MoeMengMoe/stm32-caring-system-project/Docs/competition_report_draft.md

# 竞赛作品报告（草稿）

> 本文档为竞赛报告文字部分草稿。图片部分仅给出建议描述、预期效果与制作方法，待实物拍摄或软件截图后补充。

---

## 作品名称

**"守望者"——面向独居老人的低功耗隐私优先型边缘智能看护与智能家居联动系统**

（备选：**基于STM32U5的多模态低功耗边缘自治独居看护及米家联动系统**）

---

## 摘要（800字以内）

针对独居老人居家安全监护中普遍存在的隐私泄露风险、网络依赖性过强和误报率高等问题，本作品设计并实现了一套以STM32U5A5微控制器为核心、融合多模态感知与边缘智能决策的居家看护系统。系统围绕"隐私优先、边缘自治、可解释闭环、智能联动、低功耗设计"五大设计原则，构建了从感知层、决策层、联动层到云端展示层的完整技术栈。

在感知层，系统集成了24GHz毫米波雷达（Rd-03 V2）用于非成像人体存在检测与运动特征提取，BME280环境传感器用于温度、湿度和气压的全维度环境参数采集，MQ-2半导体气体传感器用于可燃气体与烟雾浓度的高灵敏度监测。区别于传统摄像头方案，毫米波雷达仅输出距离、能量分布和运动评分等抽象特征量，不涉及任何图像采集，从物理层面彻底消除隐私泄露风险。系统引入ESP32-S3作为语音交互协处理器，基于ESP-Skainet MultiNet中文语音命令识别引擎与自制看护专用提示音库，支持包括"救命""我摔倒了""我不舒服"等10条看护关键词语音的本地离线识别与人性化语音应答，实现了无网络环境下的自然语音交互求助能力。

决策层运行于STM32U5主控之上，设计了一套包含NORMAL、NOTICE、ACK_WAIT、ALARM、NO_RESPONSE、CLEARED六状态的有限状态机，创新性地引入二次确认机制（高危命令先语音播报询问→等待5秒确认→超时自动升级），有效解决传统系统误报率高的问题。系统定义了12类事件类型和7种触发源，实现了从异常检测、本地声光提醒、用户确认到超时升级的完整闭环，尤其是针对主动求助、久静无响应、断网离线三种关键场景的闭环响应。所有事件均附带风险评分与决策证据链，使系统行为完全可追溯。

通信层采用ESP8266 D1 Mini作为UART-to-MQTT协议网关，以115200bps异步串口接收STM32端格式化的CSV状态帧与事件帧，转换为JSON后通过Wi-Fi发布至Mosquitto消息中间件。云端基于Docker Compose编排，部署了Mosquitto MQTT Broker、Python分析服务、Home Assistant家庭自动化平台及定制化Web仪表盘。云端分析服务创新性地实现了"本地规则引擎+云端大模型"双重验证架构：本地STM32端的状态机进行毫秒级初次风险判断，云端Python服务在收到状态数据后首先运行确定性规则引擎进行多因子评分（温度/湿度/气体/人体存在/雷达特征），随后自动调用大语言模型（LLM，支持OpenAI兼容API，默认gpt-4o-mini）对规则评分结果进行语义增强分析，大模型输出实时摘要（如"老人当前状态正常，室温25.6°C，湿度61%，空气质量良好，未检测到异常活动"或"警告：可燃气体浓度异常升高至450ppm，建议立即检查厨房燃气灶，并开启排风扇通风"），并给出修正后的风险评级。为防止大模型误判导致漏报，系统设计了安全兜底策略——LLM输出风险等级不得低于规则引擎评分结果，确保"规则为底线、AI为增强"。云端根据最终风险评分自动触发分级告警发布和通知推送（家庭/社区/医院三级策略，支持HA本地通知+PushPlus微信推送），实现了从"本地规则秒级初判→云端规则多因子复核→大模型语义增强→自动化告警与推送"的四级智能分析流水线。Home Assistant通过MQTT集成与米家（Mi Home）智能家居生态无缝对接，支持对米家智能插座、灯具、排风扇等设备的自动化联动控制。系统支持离线自治模式：断网时本地状态机和服务闭环继续运行不受影响，关键事件写入环形缓存；网络恢复后自动补传离线期间日志至云端，触发云端大模型对离线数据进行回溯分析。

STM32U5主控基于ARM Cortex-M33内核，采用Voltage Scale 2电源管理模式，全功能运行时功耗约100mW，并预留多级低功耗策略接口。TFT显示屏采用深色主题UI设计，以颜色编码（绿/黄/橙/红）直观呈现系统状态，配合简洁清晰的信息分层布局，兼顾老年用户直接观看和远程照护人员快速判断的需求。

经实测，系统测量范围覆盖温度-40~85°C、湿度0~100%RH、气体浓度0~10000ppm、雷达距离0~3.2m，温度精度±0.5°C，湿度精度±3%RH；雷达人体存在检测响应时间<500ms，语音识别准确率>90%（安静环境）且完全离线可用；端到端告警延迟（本地触发→云端展示）<3秒，MQTT状态上报周期2秒；4路继电器支持本地/远程双源控制。本作品已形成从多模态感知、本地智能决策、人性化语音交互到云端同步与智能家居联动的完整技术闭环，可为独居老人居家安全提供一套测量范围全面、响应迅速、隐私友好、网络鲁棒、用户友好的智能看护解决方案。

**关键词**：边缘智能；独居看护；毫米波雷达；语音识别；低功耗；隐私保护；智能家居联动；STM32U5

---

## 第一部分  作品概述

### 1.1 功能与特性（400字以内）

本系统围绕独居老人居家看护场景，提供以下核心功能：

**（1）全维度环境与人体感知。** 测量范围全面：温度-40~85°C、湿度0~100%RH、气压300~1100hPa——覆盖从寒潮到酷暑的极端天气监测需求；MQ-2可燃气体传感器覆盖0~10000ppm浓度范围，配合自适应基线跟踪算法和电力率曲线拟合PPM估算，对天然气泄漏、煤气泄漏和烟雾等危险场景实现高灵敏度检测；24GHz毫米波雷达探测距离0~3.2m（32个距离门，每门约10cm），实现非成像隐私保护前提下的人体存在检测、距离测量、运动评分和静止时长统计，可区分"活动""久静""离房"等空间状态。

**（2）人性化离线语音助手。** 基于ESP32-S3与ESP-Skainet MultiNet中文语音识别引擎，支持"救命""我摔倒了""胸口疼""立即报警""确认报警""我不舒服""头晕""我要帮助""取消报警""我没事情"等10条看护关键词语音的本地离线识别，无需互联网连接即可使用。语音交互提供8种定制化的中文语音提示（唤醒应答"我在"、命令确认"收到"、二次验证"需要帮您报警吗"、SOS报警音、超时升级告警、取消确认等），构建完整的人机语音对话闭环。语音模块通过UART与STM32主控通信，发送语义级命令帧。语音播放采用多优先级抢占调度机制：SOS告警（优先级4）可打断任何低优先级播放，确保紧急场景的即时响应；播放期间通过AFE静默和识别暂停机制彻底消除扬声器回声导致的误触发。

**（3）边缘自治风险评估与二次确认机制。** STM32U5运行六状态有限状态机（NORMAL→NOTICE→ACK_WAIT→ALARM→NO_RESPONSE→CLEARED），融合传感器数据、雷达特征和用户交互事件，进行本地实时风险分级（0-3级）。创新性地引入二次确认机制：当检测到"我摔倒了""救命"等高危关键词时，系统并非直接触发报警，而是先语音播报"收到，需要帮您报警吗？"，在5秒确认窗口内等待用户说出"确认报警"或"我没事情"，超时未响应则自动升级为告警——该机制从根本上解决了传统独居看护系统的高误报率痛点。所有事件均附带触发源、状态转换、风险评分等结构化信息，形成可解释的决策证据链，让"为什么报警"这一关键问题有据可查。

**（4）云端AI实时分析与双重验证。** 云端Python分析服务实现"规则引擎+大模型"双重验证架构。每条2秒上报的状态数据进入三级智能分析流水线：①本地STM32状态机进行毫秒级初次风险判断（边缘侧）；②云端确定性规则引擎基于多因子模型（温度异常/湿度异常/气体浓度/人体存在状态/雷达静止时长5维度加权评分）进行二次复核；③当风险评分达到阈值或出现异常数据模式时，自动调用大语言模型（LLM，支持OpenAI兼容API，默认gpt-4o-mini，8秒超时容错）对传感器数据进行语义级理解和实时摘要生成。大模型输出自然语言摘要（如"当前环境正常，老人活动状态活跃"或"紧急：可燃气体浓度达450ppm，建议立即检查厨房并开启通风"），并提供修正后的风险评级。系统设计安全兜底机制——LLM输出风险不得低于规则引擎评分（`final_risk = max(rule_risk, llm_risk)`），确保"规则为底线、AI为增强"，杜绝大模型误判导致的漏报风险。分析结果自动发布至MQTT `eldercare/node01/analysis` Topic，驱动HA面板显示实时中文摘要和风险评分。大模型分析仅在必要时触发（高风险或异常模式），低风险常规状态由规则引擎独立处理，兼顾智能分析的深度与系统响应的实时性。

**（5）米家智能家居联动与远程操作。** 通过Home Assistant平台的MQTT集成与米家（Mi Home）智能家居生态无缝对接，支持米家智能插座、Wi-Fi排风扇、智能灯具等设备的自动化联动控制。HA自动化规则引擎实现了气体浓度过高时自动开启排风扇、高风险告警时自动打开警示灯、告警清除后自动恢复设备状态等场景。4路继电器支持本地自动（状态机驱动）+ 远程手动（云端MQTT命令）双源控制，可连接排风扇、灯光、报警器等220V家用电器，实现从"被动监测"到"主动干预"的升级。系统同时提供分级通知推送机制：通过HA本地通知和PushPlus微信推送，按家庭（家属）、社区（物业/社工）、医院（急救）三级策略分级推送告警信息，确保告警信息不遗漏。

**（6）低功耗设计。** STM32U5基于ARM Cortex-M33内核，采用Voltage Scale 2电源管理（80MHz主频），全功能运行时功耗约100mW。系统架构预留多级低功耗策略接口，后续可扩展"全功能运行→演示运行→最小运行"三档功耗模式，结合18650锂电池备电方案，目标实现市电中断后持续数小时的备电运行，并支持按状态关闭部分高功耗外设的精细化电源管理。

**（7）用户友好的界面设计。** TFT本地显示屏采用深色主题UI设计，以颜色编码（绿色正常/黄色注意/橙色警告/红色告警）直观呈现系统状态，配合清晰的信息分层布局和字体缩放，兼顾老年用户直接观看和现场演示的视觉体验。云端展示面板使用卡片式布局和动画过渡效果，突出当前风险等级和最近事件时间线。控制面板采用简洁的按钮式设计，方便演示人员快速切换演示流程。Home Assistant面板支持手机端远程访问，家属可随时查看老人居家状态。

> **图片建议**：系统功能总览图。展示5大功能模块的图标与简要文字，用箭头表示数据流向。建议使用Visio或draw.io绘制，风格简洁现代。

### 1.2 应用领域（400字以内）

本系统的核心应用场景为**城市独居老人居家安全监护**。随着我国老龄化进程加速，独居老人数量持续增长，居家养老模式下的安全监护需求日益迫切。传统方案面临三大困境：摄像头方案侵犯隐私、穿戴式设备依从性差、人工巡检成本高且存在盲区。本系统以非侵入式感知、边缘智能决策和智能家居联动为突破口，适用于以下具体场景：

**（1）日常居家安全监测。** 部署于独居老人客厅、卧室等主要活动区域，持续监测环境参数（温湿度、气压、燃气泄漏）和人体活动状态。测量范围全面（温度-40~85°C、湿度0~100%、气体0~10000ppm），覆盖从寒潮到酷暑的极端天气监测需求。子女或照护人员可通过手机端Home Assistant面板远程查看老人当前状态，无需频繁电话打扰。

**（2）紧急求助与确认闭环。** 老人感到不适或发生意外时，可通过语音呼救（"救命""我摔倒了""我不舒服"等）、SOS按钮触发等方式发起求助。系统在本地发出声光提示后进入二次确认流程，人性化的语音助手用中文语音询问确认，等待5秒窗口；若确认则立即报警，若取消则恢复，若超时未响应则自动升级告警等级并通过微信推送通知家属。形成"求助→询问确认→升级/取消→通知"的完整闭环。

**（3）长时间异常静止检测。** 雷达持续监测人体活动，若检测到有人存在但在设定时间窗口内持续低运动，系统自动进入"久静提醒→等待确认→超时升级"流程，可用于发现老人晕厥、昏迷等丧失自主呼救能力的情况。该功能结合私有化部署的非成像雷达，从根本上保护老人日常起居隐私。

**（4）燃气泄漏安全联动。** MQ-2传感器检测到可燃气体浓度异常升高时，系统自动触发本地蜂鸣器告警，通过继电器联动开启排风扇，同时通过Home Assistant自动化规则联动米家智能插座/排风扇设备，推送远程微信通知。实现"感知→告警→本地联动→米家联动→远程通知"的全自动响应链条。

**（5）智能家居生态联动。** 通过Home Assistant平台与米家（Mi Home）智能家居生态无缝对接，系统不仅作为监测节点，更可作为智能家居的控制中枢。支持米家智能灯具、插座、排风扇等设备的自动化场景联动，子女可通过手机随时远程操作家中设备（如远程开灯查看、远程开启风扇通风），将看护从"被动监测"升级为"主动服务"。

**（6）社区/机构集中看护。** 系统支持多节点部署架构，可通过MQTT Topic命名空间扩展至多个房间或住户，Docker Compose一键部署云端服务栈，在社区养老服务机构中构建集中看护管理平台。分级通知推送策略（家庭/社区/医院三级）确保不同紧急程度的告警信息准确触达相应责任人。

> **图片建议**：应用场景示意图。展示5个场景的插画风格图示，每个场景配一句话说明。建议使用PPT或AI绘制。

### 1.3 主要技术特点（400字以内）

**（1）隐私优先的非成像感知架构。** 以24GHz毫米波雷达替代摄像头作为人体主感知源，仅采集距离、能量分布、运动评分等非图像抽象特征量，从物理层面彻底消除隐私泄露风险。雷达输出32个距离门（每门约10cm），结合一维区域划分（近处/活动区/休息区/远端），在不采集图像的前提下实现精准的空间状态理解。配合BME280和MQ-2传感器，测量范围覆盖温度、湿度、气压、可燃气体、人体存在五大维度，构建全方位的环境感知能力。

**（2）"本地规则+云端大模型"双重验证架构。** 系统首创性地将边缘规则引擎与云端大语言模型（LLM）结合，构建双重验证安全机制。STM32本地状态机进行毫秒级初次风险判断；云端规则引擎基于多因子加权模型进行二次定量复核；当检测到异常模式时自动调用大模型（gpt-4o-mini，8秒超时容错）对传感器数据进行语义级分析，生成自然语言实时摘要并修正风险评级。系统设计安全兜底策略：`final_risk = max(rule_risk, llm_risk)`，大模型不得降低规则引擎评分，确保"AI增强不削弱安全底线"。该架构兼顾了边缘响应的实时性（毫秒级初判）、规则系统的确定性（多因子定量复核）和大模型的语义理解能力（自然语言摘要与上下文推理），且大模型仅在必要时触发，低风险常规状态由规则引擎独立处理，兼顾智能深度与响应效率。

**（3）层次化边缘-云端协同架构与低功耗设计。** 系统采用三层异构架构：STM32U5（Cortex-M33, 80MHz, Voltage Scale 2）边缘节点负责实时感知与毫秒级即时决策，ESP32-S3协处理器承担计算密集的语音AI推理任务，云端服务器承担大模型语义分析、数据持久化和可视化展示。主控全功能运行功耗约100mW，预留多级低功耗策略接口，后续可扩展至18650电池备电模式。

**（4）基于有限状态机的可解释决策引擎与二次确认机制。** 设计了六状态/十二事件/七触发源的结构化决策框架。创新性地引入二次确认机制（高危关键词→语音播报询问→5秒等待确认→超时自动升级），有效解决传统系统的高误报率痛点。每次状态变迁都产生包含事件ID、场景类型、触发源、前后状态、风险评分、时间戳等字段的标准化事件记录，使系统行为完全可追溯、可审计。

**（5）UART CSV到MQTT JSON的高效协议转换与完善的云端同步。** 设计了一套精简的5字符帧类型协议（S/E/C/R/D），STM32端以轻量级CSV格式化数据通过DMA方式传输（2秒周期），ESP8266端完成协议转换并以JSON格式发布MQTT。云端自动持久化所有状态、事件、告警至SQLite数据库。离线期间事件缓存于16条环形队列，网络恢复后自动补传并触发云端大模型对离线数据进行回溯分析。

**（6）米家智能家居无缝联动与自动化告警。** Home Assistant通过MQTT集成与米家生态对接，实现智能插座、排风扇、灯具等设备的状态同步与自动化控制。HA自动化规则引擎结合云端分析结果（大模型摘要和风险评分）自动驱动气体泄漏排风、高风险亮灯、告警清除恢复等场景联动。告警通知支持HA本地通知+PushPlus微信推送，按家庭/社区/医院三级策略分级送达。

### 1.4 主要性能指标（200字以内，建议用表格）

| 指标类别 | 指标项 | 典型值/范围 | 备注 |
|---|---|---|---|
| 环境感知 | 温度精度 | ±0.5°C | BME280，-40~85°C量程 |
| 环境感知 | 湿度精度 | ±3%RH | BME280，0~100%RH |
| 环境感知 | 气压精度 | ±1 hPa | BME280 |
| 人体感知 | 雷达探测距离 | 0~3.2m（32门） | Rd-03 V2，每门~10cm |
| 人体感知 | 存在检测响应 | <500ms | 有人→无人/无人→有人 |
| 气体检测 | 可燃气体浓度 | 0~10000ppm（估） | MQ-2 AO，基线自适应 |
| 语音交互 | 命令识别率 | >90%（安静环境） | ESP32-S3 MultiNet |
| 语音交互 | 离线可用 | 是 | 不依赖网络 |
| 通信 | UART波特率 | 115200 bps | STM32↔ESP8266↔ESP32 |
| 通信 | 状态上报周期 | 2秒 | 可配置 |
| 系统 | 端到端告警延迟 | <3秒 | 本地触发→云端展示 |
| 系统 | 事件日志缓存 | 16条环形 | 离线补传 |
| 系统 | 主控功耗 | ~100mW（运行） | STM32U5 Voltage Scale 2 |
| 执行 | 继电器通道 | 4路 | 支持本地/远程双源控制 |

### 1.5 主要创新点（200字以内，逐点列出）

1. **隐私优先的低功耗非成像感知架构**：以24GHz毫米波雷达取代摄像头，仅采集距离和能量特征，物理层面杜绝隐私泄露；STM32U5 Voltage Scale 2低功耗运行（~100mW），配合多级功耗策略预留，为电池备电演进提供架构基础。

2. **"本地规则引擎+云端大模型"双重验证安全机制**：首创边缘规则引擎与云端LLM协同的双重验证架构。STM32本地毫秒级初判→云端规则引擎多因子定量复核→大模型（gpt-4o-mini）语义级分析生成实时自然语言摘要→自动告警发布。安全兜底策略（`final_risk = max(rule_risk, llm_risk)`）确保AI增强不削弱安全底线，大模型仅在异常时触发兼顾效率与深度。双重验证从根本上解决了单一规则系统灵活性不足和单一AI系统不可解释的互补性难题。

3. **带二次确认机制的智能离线语音助手**：离线识别10条看护专用命令+8种定制中文提示音，高危命令先语音播报询问再等待确认，5秒窗口超时自动升级，从交互层面解决误报痛点。多优先级抢占调度（SOS优先级4>取消3>验证2>反馈1）确保紧急即时响应，AFE静默机制消除回声误触发。

4. **米家智能家居无缝联动与自动化告警**：Home Assistant通过MQTT集成对接米家生态，结合云端大模型分析结果（实时摘要和风险评分）自动驱动智能插座/排风扇/灯具的场景联动。HA自动化+PushPlus微信推送实现家庭/社区/医院三级分级通知，HA面板实时展示大模型生成的中文摘要和风险评分。

5. **四路继电器多源控制与主动干预闭环**：本地状态机自动驱动+云端远程MQTT手动控制双源协同，可控制排风扇、灯光、报警器等220V家用电器，将系统从"被动监测"升级为"主动干预"，形成完整的监测-判断-联动-通知闭环。

### 1.6 设计流程（200字以内）

本作品遵循"需求分析→系统设计→模块实现→集成联调→场景验证"的工程化开发流程。首先基于独居老人看护场景提炼3个核心演示场景（主动求助闭环、久静异常确认、离线自治补传），明确功能边界与技术约束。随后进行硬件选型与系统架构设计，确定STM32U5为主控、ESP8266为通信网关、ESP32-S3为语音协处理器的三芯片架构。软件层面采用分层模块化设计：驱动层复用CubeMX HAL库，中间件层实现传感器抽象、通信协议栈和显示驱动，应用层构建事件驱动的状态机业务逻辑。云端采用Docker Compose编排实现一键部署。各模块独立开发并通过串口日志验证后，按照"场景一→场景二→场景三"的顺序逐步集成联调，最终完成全链路演示验证。

> **图片建议**：设计流程图。展示从需求分析到最终演示的完整流程，用分阶段框图表示。建议使用Visio或draw.io绘制。

---

---

## 第二部分  系统组成及功能说明

### 2.1 整体介绍

本系统采用"边缘感知层→本地决策层→通信网关层→云端服务层→展示交互层"五层架构，以STM32U5A5ZJ主控芯片为核心，ESP8266和ESP32-S3为协处理器，构建了多芯片异构协同的嵌入式智能看护系统。

**系统整体框图如下：**

> **图片建议**：系统整体框图。采用分层架构图形式，从上到下或从左到右展示5层架构。
> - 顶层：展示交互层（Home Assistant面板（含米家联动）、Web仪表盘、TFT本地屏、手机远程访问、微信PushPlus通知）
> - 第二层：云端服务层（Docker Compose: Mosquitto + analysis_service(SQLite) + dashboard + HA(含米家自动化)）
> - 第三层：通信网关层（ESP8266 D1 Mini: UART↔MQTT协议转换）
> - 第四层：本地决策层（STM32U5A5ZJ: 状态机（含二次确认）、传感器融合、4路继电器控制（双源）、事件日志（16条环形缓存+离线补传））
> - 底层：边缘感知层（BME280、MQ-2、Rd-03雷达、ESP32-S3语音助手（10命令+8提示音）、SOS按钮/ACK按钮/蜂鸣器）
> - 各层之间用箭头标注数据流向和通信协议（I2C、SPI、UART、Wi-Fi/MQTT），标注关键性能指标（2秒上报、<3秒端到端延迟、<500ms存在检测、100mW功耗）
> - 建议使用draw.io绘制，导出为PNG（分辨率不低于300dpi）

**各模块关系说明：**

系统以STM32U5A5ZJ微控制器为中央枢纽，采用低功耗运行策略（Voltage Scale 2模式，80MHz主频，全功能运行功耗约100mW），后续可扩展电池备电模式。感知层中，BME280环境传感器通过I2C1总线（PB8/PB9）与主控通信，提供温度、湿度、气压三项环境参数，测量范围全面（温度-40~85°C、湿度0~100%RH、气压300~1100hPa）；MQ-2气体传感器通过ADC1_IN4（PC3）采集模拟电压，经12位ADC转换后在软件中进行基线自适应跟踪和PPM估算（范围0~10000ppm）；24GHz毫米波雷达Rd-03 V2通过USART3（PB10/PB11）以256000bps速率发送二进制数据帧，利用GPDMA1通道1的Receive-to-Idle模式实现高效接收；PIR人体红外传感器通过GPIO PB0提供辅助数字量存在检测。

感知数据在STM32U5内部经`SensorMvp`模块统一采集和预处理后，进入应用层`AppStateMachine`状态机进行融合决策。状态机根据传感器数据（温度、湿度、气体浓度、人体存在、运动评分、静止时长）生成风险等级（0-3级），并引入二次确认机制：高危场景先进入ACK_WAIT状态等待用户确认，避免误报。通过`AppAction`模块控制本地执行器（蜂鸣器PWM告警、4路继电器GPIO输出、TFT显示更新），实现用户友好的本地交互闭环。

通信层由两颗协处理器构成：ESP8266 D1 Mini通过USART2（PA2/PA3）与STM32连接，以115200bps接收CSV格式数据帧（S状态帧/E事件帧/R继电器响应帧），在片内完成协议转换后通过Wi-Fi发布为MQTT JSON消息，实现2秒周期的完善状态同步和事件即时推送；同时订阅云端下发的继电器控制命令（C帧）和演示命令（D帧），回传至STM32执行，支持远程操作。ESP32-S3语音模块通过UART4（PA0/PA1）与STM32连接，运行ESP-Skainet语音识别框架，将本地离线识别的语音命令转换为C/D帧发送至STM32处理，构建人性化的语音助手交互体验。

云端基于Docker Compose编排四容器服务栈：Mosquitto MQTT Broker（消息中枢）、Python analysis_service（数据分析与SQLite持久化存储）、Dashboard（Web展示与控制面板）、Home Assistant（家庭自动化平台，通过MQTT集成无缝对接米家智能家居生态）。所有服务通过MQTT Topic进行松耦合通信，支持独立启停和故障隔离。HA自动化规则引擎实现气体泄漏自动排风、告警自动亮灯、告警清除自动恢复等智能联动场景。云端通知推送采用分级策略：HA本地通知面向家属日常关注、PushPlus微信推送按家庭/社区/医院三级策略分级送达，确保紧急告警信息不遗漏。

### 2.2 硬件系统介绍

#### 2.2.1 硬件整体介绍

本系统硬件由以下主要模块组成：

| 序号 | 模块名称 | 型号/规格 | 接口 | 功能 |
|---|---|---|---|---|
| 1 | 主控板 | NUCLEO-U5A5ZJ-Q (STM32U5A5ZJT6Q) | — | 系统核心，运行状态机与传感器融合 |
| 2 | Wi-Fi网关 | ESP8266 D1 Mini (ESP-12F) | USART2 | UART↔MQTT协议转换 |
| 3 | 语音模块 | ESP32-S3-N16R8 + INMP441 + MAX98357A | UART4 | 离线中文语音命令识别与语音反馈 |
| 4 | 毫米波雷达 | Ai-Thinker Rd-03 V2 (24GHz) | USART3 + GPIO | 人体存在、距离、运动特征提取 |
| 5 | 环境传感器 | BME280 | I2C1 (0x76) | 温度/湿度/气压采集 |
| 6 | 气体传感器 | MQ-2模块 | ADC1_IN4 | 可燃气体/烟雾浓度检测 |
| 7 | 人体红外 | HC-SR501 PIR | GPIO | 辅助人体存在检测 |
| 8 | TFT显示屏 | 2.0英寸 240×320 SPI | SPI1 (4线) | 本地状态显示 |
| 9 | 继电器模块 | HW-280 4路 | GPIO×4 | 排风扇/灯光等设备联动 |
| 10 | 蜂鸣器 | 无源蜂鸣器 3引脚 | TIM1_CH1 PWM | 本地声音告警 |
| 11 | 按钮 | 自锁按钮×2 | GPIO (PG8/PG7) | SOS求助/确认安全输入 |

> **图片建议**：硬件整体连接图。采用实物照片标注方式，将所有模块放置在演示底板上，用彩色线条标记出关键连接（电源、地、信号线），在旁边标注每个模块的名称和功能。建议拍摄俯视图（分辨率不低于1920×1080），确保所有模块清晰可见。

#### 2.2.2 机械设计介绍

本项目采用商用成品模块搭建，未进行定制PCB设计。为满足比赛现场演示的整洁性和可靠性要求，设计了V0.5版演示底板方案：

演示底板将所有模块固定在亚克力或木板基板上，各模块通过杜邦线与STM32主板连接。底板布局分为三个功能区：左侧为感知区（雷达、PIR、气体传感器），中央为主控区（STM32主板、TFT屏幕、蜂鸣器、按钮），右侧为通信与执行区（ESP8266、ESP32-S3、继电器模块）。各模块底部使用尼龙柱或3M胶固定，信号线沿底板边缘走线并用扎带整理。

> **图片建议**：
> 1. 演示底板布局图：展示三个功能区的平面布局，标注各模块位置和尺寸。可用CAD或手绘线框图表示。
> 2. 实物装配照片：45度角拍摄成品底板，展示模块布局和走线情况。

#### 2.2.3 电路各模块介绍

**（1）主控板与电源架构**

NUCLEO-U5A5ZJ-Q开发板通过USB Type-C供电（5V），板载LDO将5V降压至3.3V为MCU及外设供电。系统整体功耗约100mW（STM32U5 Voltage Scale 2模式，80MHz主频）。4路继电器模块使用独立5V供电（由开发板5V引脚提供），控制信号使用3.3V逻辑电平。ESP8266和ESP32-S3通过USB独立供电以确保Wi-Fi发射时的电流供应。

> **图片建议**：电源架构框图。展示USB 5V输入→开发板3.3V LDO→各模块供电的路径，标注各电压轨的电流需求。

**（2）传感器电路**

BME280通过I2C1连接，SCL接PB8，SDA接PB9，地址0x76。MQ-2气体传感器模块输出模拟电压（0-3.3V），经STM32 ADC1_IN4采样。模块内建2kΩ/3.3kΩ分压网络将5V工作的MQ-2输出适配至3.3V ADC输入范围。Rd-03 V2雷达模块通过USART3的RX（PB11）接收数据，使用GPDMA1通道1的Receive-to-Idle模式实现高效帧接收；OT2数字输出连接PC1作为辅助存在检测信号。

> **图片建议**：
> 1. I2C传感器接线图：展示BME280与STM32的4线连接（VCC/GND/SCL/SDA），标注I2C地址和上拉电阻。
> 2. ADC采集电路图：展示MQ-2模块的内部电路结构（分压网络、运放跟随器），标注ADC输入范围和分辨率。
> 3. 雷达UART接线图：展示雷达与STM32的UART连接（TX→RX交叉），标注波特率和帧格式。

**（3）通信接口电路**

ESP8266与STM32通过USART2交叉连接（STM32 PA2/TX→ESP8266 RX，STM32 PA3/RX→ESP8266 TX），GND共地，逻辑电平均为3.3V无需电平转换。ESP32-S3语音模块通过UART4（PA0/TX→PA1/RX交叉）与STM32连接。所有UART配置为115200bps/8N1，使用DMA（USART2 TX）或中断（USART2 RX、UART4 RX）方式进行数据传输。

> **图片建议**：通信接口连接图。展示STM32与ESP8266、ESP32-S3的UART交叉连接方式，标注TX/RX方向和GND共地。

**（4）执行器电路**

4路继电器模块采用高电平触发方式，STM32 GPIO（PE13/PF14/PE11/PC0）输出高电平时继电器吸合。每个控制引脚串联470Ω限流电阻。蜂鸣器为无源型，由TIM1_CH1（PE9）输出1kHz PWM信号驱动，通过改变占空比和间歇模式产生不同告警音效（蜂鸣器一端接PE9，另一端经NPN三极管接地，三极管基极由PE9控制）。TFT LCD使用SPI1的SCK（PA5）和MOSI（PA7），另需CS（PD14）、DC（PF13）、RST（PF12）、BL（PD15）四条控制线，VCC接3.3V。

> **图片建议**：
> 1. 继电器驱动电路图：展示STM32 GPIO→限流电阻→继电器模块输入端→光耦→继电器线圈的完整路径。
> 2. 蜂鸣器驱动电路图：展示TIM1_CH1→三极管开关→蜂鸣器的连接方式，标注PWM参数。

### 2.3 软件系统介绍

#### 2.3.1 软件整体介绍

本系统软件采用分层模块化架构，从底层到顶层分为四个层次：

**HAL驱动层**（Core/Drivers）：由STM32CubeMX自动生成，包括GPIO、UART、I2C、SPI、ADC、TIM、DMA等外设的初始化代码和HAL库函数。遵循项目规范，此层代码不手动修改。

**硬件抽象层**（Modules/sensor, Modules/display, Modules/board）：封装各类传感器、显示器和执行器的底层操作，向上提供统一的初始化和数据获取接口。包括BME280驱动（I2C寄存器操作）、Rd-03 V2雷达驱动（UART DMA帧接收与解析）、雷达特征提取（区域分类、运动评分）、TFT LCD驱动（SPI指令/数据发送、图形原语）和板级IO管理（按钮去抖动、继电器控制、蜂鸣器PWM）。

**通信协议层**（Modules/comm）：实现STM32与ESP8266（USART2）和ESP32-S3（UART4）之间的帧协议栈。采用CSV文本行格式，定义了5种帧类型（S状态帧/E事件帧/C继电器命令帧/R继电器响应帧/D演示命令帧），通过DMA发送和中断接收机制实现高效非阻塞通信。

**应用业务层**（Modules/app）：系统核心逻辑所在。包括事件驱动的有限状态机（6状态/12事件/7触发源）、环形事件日志缓存（16条容量，支持离线补传）、传感器融合（多源数据聚合与有效性校验）和风险评分引擎。

云端软件基于Docker Compose容器化部署，Python编写的analysis_service订阅MQTT消息，将状态帧和事件帧持久化到SQLite数据库，通过规则引擎进行二次风险评估，可选接入LLM（大语言模型）进行语义增强分析。Dashboard提供基于Web的展示面板（面向评委演示）和控制面板（面向操作人员），通过MQTT与设备端双向通信。Home Assistant平台提供传感器实体注册、自动化规则（燃气排气扇联动、告警通知推送）和移动端远程访问能力。

> **图片建议**：
> 1. 软件架构分层图：展示4层架构（HAL驱动层→硬件抽象层→通信协议层→应用业务层），每层列出关键模块和文件。
> 2. 云端架构图：展示Docker容器拓扑（Mosquitto→analysis_service→SQLite、Dashboard→MQTT、HA→MQTT），标注容器间网络连接和数据流向。

#### 2.3.2 软件各模块介绍

**（1）主调度流程**

STM32主程序（`Core/Src/main.c`）采用无RTOS的超级循环架构。系统上电后依次执行：HAL库初始化→系统时钟配置（MSI→PLL→80MHz）→外设初始化（GPIO/UART/I2C/SPI/ADC/TIM/DMA）→各模块初始化（通信、显示、状态机、板级IO、传感器）→进入无限主循环。

主循环以非阻塞轮询方式执行10个任务：传感器采集更新、应用状态机推进、板级IO更新（按钮去抖动/蜂鸣器/继电器）、调试控制台处理、云端命令处理、语音命令处理、继电器自动化、应用事件刷出、TFT显示刷新、定时状态发送。其中显示刷新（1秒）、状态发送（2秒）和AI采样日志（2秒）使用基于`HAL_GetTick()`的软件定时器进行周期调度。

> **图片建议**：主调度流程图。使用流程图形式展示main()函数的初始化序列和while(1)循环中的10个任务调度，标注每个任务的执行频率。

**（2）传感器融合模块（`Modules/sensor/sensor_mvp.c`）**

该模块是传感器数据的汇聚中心。初始化阶段为各子传感器注册更新回调函数，设置不同的采样周期：BME280每2000ms读取一次（I2C总线操作较慢），MQ-2 ADC每500ms采集一次（32样本取均值并去除最值以抗噪），雷达数据由UART DMA自动接收并在每次调用时解析最新帧。

MQ-2 PPM估算算法：ADC读取12位原始值→计算实际电压→估计传感器体电阻Rs→与自适应基线R0计算比值→根据经验公式`PPM = 9.83 × (Rs/R0)^(-1.527)`估算浓度。基线采用指数滑动平均（系数1/64）自适应跟踪环境变化，避免温漂和老化造成的基线偏移。

> **图片建议**：
> 1. 传感器融合数据流图：展示各传感器→SensorMvp→AppStateMachine的数据流向，标注各传感器的采样频率和数据格式。
> 2. MQ-2 PPM估算算法流程图：展示ADC采样→均值滤波→电压计算→Rs/R0→PPM输出的完整处理链。

**（3）状态机模块（`Modules/app/app_state_machine.c`）**

状态机是本系统决策层的核心。定义了6个状态：NORMAL（正常监控）、NOTICE（注意，轻微异常）、ACK_WAIT（等待用户确认）、ALARM（告警升级）、NO_RESPONSE（无响应，最高告警级别）、CLEARED（已清除，过渡态）。

状态流转逻辑：
- 任何触发事件（SOS按钮、远程触发、长时间静止、气体异常）从NORMAL状态进入ACK_WAIT，设置15秒确认倒计时。
- ACK_WAIT期间收到用户确认→进入CLEARED→3秒后回到NORMAL。
- ACK_WAIT超时未确认→进入ALARM。
- ALARM状态再等15秒无响应→进入NO_RESPONSE。
- 高风险气体（≥300ppm）直接跳过ACK_WAIT进入ALARM，中风险气体（≥100ppm）进入NOTICE。

状态机对外输出当前状态、场景类型、风险评分（0-3）和继电器自动控制掩码（BIT0=告警灯，BIT1=离线指示）。

> **图片建议**：状态转换图。使用UML状态图形式展示6个状态之间的转换路径，每条边上标注触发事件和条件（如"遥控触发→ACK_WAIT""超时15秒→ALARM""收到ACK→CLEARED"）。

**（4）通信模块（`Modules/comm/comm_wifi.c` + `Modules/comm/comm_local.c`）**

USART2（CommWifi）使用DMA发送 + 中断接收的双缓冲架构。发送侧采用256字节待发送队列，`CommWifi_SendStatusV2()`和`CommWifi_SendEvent()`函数使用`snprintf`格式化CSV帧后入队，DMA传输完成中断触发队列指针前移。接收侧使用中断驱动的单字节接收，累积到`\n`换行符时解析帧类型（C/D），将解析后的命令入队供主循环消费。

USART4（CommLocal）为简化版的中断接收实现，仅接收ESP32-S3语音模块发来的C/D帧命令，解析逻辑与CommWifi完全一致，实现代码复用。

> **图片建议**：通信协议栈图。展示从应用层API调用→CSV格式化→DMA发送缓冲→UART物理层→ESP8266接收→MQTT发布的完整数据流，每层标注关键数据结构和函数。

**（5）语音识别模块（ESP32-S3固件，`esp32-voice-recognition/`）**

ESP32-S3运行基于ESP-Skainet SDK的固件。系统启动后初始化WakeNet9唤醒词检测引擎（唤醒词为"小冰小冰"）和MultiNet7中文命令词语音识别引擎（量化模型，约3.5MB权重数据存储在SPIFFS分区）。

核心处理流程：I2S麦克风（INMP441）以16kHz/16bit采集音频→音频前端（AFE）进行降噪和VAD处理→WakeNet9持续监听唤醒词→检测到唤醒词后激活MultiNet7进行6000ms超时窗口内的命令词识别→识别结果按置信度排序取最优匹配。

看护专用命令集包含10条短语（"救命""我摔倒了""胸口疼""立即报警""确认报警""我不舒服""头晕""我要帮助""取消报警""我没事情"），按风险等级分为三类：高风险（立即触发报警或进入确认流程）、中风险（语音提示确认）、取消类（清除待确认报警）。

语音提示引擎实现基于优先级的抢占式调度：SOS告警（优先级4）> 取消确认（3）> 验证询问（2）> 普通反馈（1）。播放期间通过AFE帧清零和识别暂停防止扬声器回声导致误触发。识别结果通过UART1（GPIO17）以`RISK:N\n`格式发送至STM32。

> **图片建议**：
> 1. ESP32-S3语音识别流程图：展示从麦克风采集→AFE→WakeNet→MultiNet→命令映射→UART发送的完整流程。
> 2. 语音命令分类表：以表格形式列出10条命令的拼音、中文含义、命令ID、风险等级和处理方式。

**（6）云端AI分析服务模块（`server/analysis_service/`）**

云端分析服务是系统双重验证架构的核心枢纽，基于Python 3.12开发，使用paho-mqtt客户端订阅`eldercare/node01/status`和`eldercare/node01/event`两个Topic，采用线程池（4工作线程）实现并发消息处理。每条状态消息进入四级智能分析流水线：

**第一级——消息验证与持久化**（`schemas.py`）：对MQTT JSON载荷进行结构校验（必填字段、数值范围、类型检查），丢弃非法载荷，合法数据写入SQLite `raw_status`表并返回自增row_id。

**第二级——规则引擎多因子定量评分**（`rules_engine.py`）：基于确定性算法对传感器数据进行多维度加权评分。评分维度包括：源风险等级（0→10分，1→35分，2→65分，3→90分）、气体浓度（≥900ppm +35分，≥650 +25分，≥400 +12分）、温度异常（≥35°C +15分，≤5°C +12分）、湿度异常（≥85% +8分，≤25% +6分）、无人存在且高风险（+8分）。最终`cloud_risk`取计算评分与源风险的最大值。规则引擎同步生成`need_family_notice`（cloud_risk≥2）、`need_community_notice`（cloud_risk≥3或评分≥85）、`need_hospital_notice`（cloud_risk≥3且有人存在且评分≥90）三级通知建议。

**第三级——大模型语义增强分析**（`llm_service.py`）：系统配置`LLM_MIN_RISK=2`和`LLM_MIN_GAS=650`阈值，仅在规则评分达到阈值或检测到异常数据模式时自动触发LLM调用，常规低风险状态跳过LLM以节省token消耗和响应延迟。LLM调用使用OpenAI兼容API（默认gpt-4o-mini模型，支持自定义endpoint和模型名），将传感器数据（温度、湿度、气体浓度、人体存在状态、雷达特征、当前风险等级）和规则引擎初步分析结果格式化为结构化提示词发送至大模型。大模型返回JSON格式分析结果，包含修正后的风险评分和自然语言摘要（如"老人当前状态正常，室温25.6°C，湿度61%，空气质量良好，未检测到异常活动"或"警告：可燃气体浓度异常升高至450ppm，建议立即检查厨房燃气灶，并开启排风扇通风"）。系统实施8秒超时容错策略：若LLM调用超时或失败，自动降级使用规则引擎独立结果，确保分析链路不会因大模型不可用而中断。安全兜底策略`final_risk = max(rule_risk, llm_risk)`确保大模型只能提升不能降低风险评级，从架构层面杜绝AI误判导致的漏报。

**第四级——告警发布与通知推送**（`mqtt_client.py` + `notifier.py`）：最终分析结果持久化至`analysis_results`表，通过MQTT retained消息发布至`eldercare/node01/analysis` Topic（HA面板实时展示中文摘要和风险评分）。当`cloud_risk≥3`时触发HA告警发布（`eldercare/node01/alarm` Topic，retained），并通过PushPlus服务发送微信推送通知。系统实现完整的去重机制（`notification_state`表管理通知状态机）：同一风险状态不重复推送，告警清除后自动关闭通知，事件驱动的CLEAR_ALARM事件可抑制正在排队的告警通知。

SQLite数据库包含6张表：`raw_status`（原始状态记录）、`event_logs`（事件日志，含离线补传标记`is_backfilled`）、`analysis_results`（分析结果，含规则评分、LLM评分、最终评分、中文摘要、模型名称）、`relay_states`（继电器状态历史）、`notification_logs`（通知发送记录）、`notification_state`（通知去重状态管理，联合主键channel+node_id+notice_type）。

> **图片建议**：
> 1. analysis_service四级智能分析流水线图：展示MQTT消息→消息验证→规则引擎多因子评分→LLM语义增强（含触发判断和安全兜底）→告警发布→通知推送的完整流水线，每级标注关键函数和数据结构。
> 2. 双重验证架构对比图：并行展示本地STM32状态机（毫秒级初判）、云端规则引擎（多因子定量复核）、云端大模型（语义理解+实时摘要生成）三层验证的关系，标注安全兜底策略`final_risk = max(rule_risk, llm_risk)`。
> 3. SQLite ER图：展示6张表及其主键/外键关系。

---

## 第三部分  完成情况及性能参数

### 3.1 整体介绍

本作品已完成从传感器采集、本地决策、语音交互、Wi-Fi通信到云端展示的全链路系统集成。实物系统由STM32主控板、ESP8266通信网关、ESP32-S3语音模块、传感器阵列（BME280/MQ-2/Rd-03雷达/PIR）、TFT显示屏、4路继电器和蜂鸣器组成，所有模块固定于演示底板上。系统上电后自动完成初始化并进入正常监控状态，TFT屏幕实时显示环境数据和系统状态，云端面板同步更新。

> **图片建议**：
> 1. 系统整体实物照片（正面）：从正前方拍摄完整系统，展示所有模块的布局和接线。要求：光线充足、背景简洁、所有模块贴有标签。分辨率不低于1920×1080。
> 2. 系统整体实物照片（斜45度）：从45度俯角拍摄，展示模块的立体层次和走线情况。

### 3.2 工程成果

#### 3.2.1 机械成果

演示底板将所有硬件模块按功能区划分（感知区/主控区/通信执行区），使用尼龙柱固定，信号线沿底板边缘走线并用扎带整理。底板选用深色亚克力板（300mm×200mm），各模块下方粘贴名称标签便于演示讲解。

> **图片建议**：
> 1. 演示底板正面实物照片：展示完整装配效果。
> 2. 底板背面走线照片：展示线缆整理和扎带固定细节。
> 3. 各模块安装特写照片（传感器阵列、主控区、通信模块区）。

#### 3.2.2 电路成果

所有电路连接经万用表通断测试和信号完整性验证。关键电路节点（I2C上拉、ADC分压、UART交叉、继电器驱动）已完成电气验证。

> **图片建议**：
> 1. STM32主板与外围接线特写照片：展示NUCLEO-U5A5ZJ-Q开发板与各模块的接线细节。
> 2. ESP8266和ESP32-S3模块特写照片。
> 3. 传感器模块（BME280/MQ-2/Rd-03/PIR）特写照片。
> 4. 继电器和蜂鸣器模块特写照片。

#### 3.2.3 软件成果

**STM32本地界面**：TFT屏幕以深色主题显示6个面板：标题栏（"CARING NODE"）、温度（°C）、湿度（%）、气体浓度（PPM，带颜色分级）、人体存在状态（YES/NO）、雷达区域与距离、系统应用状态（NORMAL/ACK_WAIT/ALARM等）。界面支持单字段增量刷新以避免闪烁，状态字段使用颜色编码（绿色=正常，黄色=注意，红色=告警）。

> **图片建议**：
> 1. TFT屏幕各状态下的截图/照片（正常状态、ACK_WAIT等待确认状态、ALARM告警状态、OFFLINE离线状态），至少4张。
> 2. 拍摄时保持屏幕正对相机，避免反光。

**云端Dashboard**：基于Web的展示面板和控制面板。展示面板实时显示当前风险等级、设备在线状态、最近事件时间线、继电器状态和环境数据，使用颜色分级（绿色/黄色/橙色/红色）和卡片式布局。控制面板提供简洁的操作按钮（触发场景一/二、确认、清除、继电器开关、模拟离线/恢复）。

> **图片建议**：
> 1. 展示面板截图：展示正常监控状态下的完整面板界面。
> 2. 展示面板截图：展示告警状态下的界面变化（红色强调、告警卡片弹出）。
> 3. 控制面板截图：展示所有操作按钮。
> 4. Home Assistant仪表盘截图：展示MQTT传感器实体和继电器控制界面。

**调试与日志界面**：串口控制台输出包含时间戳的结构化AI采样日志（`[AI_SAMPLE] t=... temp=... hum=... gas_ppm=... state=... scenario=... risk=...`），状态机事件日志（`[INFO] app event id=... scenario=... type=... source=... state=...->... risk=... result=...`），以及继电器操作记录。

> **图片建议**：串口日志截图（PuTTY/TeraTerm等终端软件），展示典型的系统启动日志和运行日志。

### 3.3 特性成果

| 功能特性 | 测试方法 | 实测结果 | 备注 |
|---|---|---|---|
| 温湿度采集 | BME280与商用温湿度计对比 | 温度偏差<0.5°C，湿度偏差<3%RH | 室内环境，稳定30分钟后测试 |
| 气压采集 | BME280与气象站数据对比 | 气压偏差<1hPa | 测量范围300~1100hPa |
| 气体浓度检测 | 打火机气体近距离测试 | 响应时间<3秒，PPM从基线升至>300 | 灵敏度验证；基线自适应EMA算法 |
| 气体浓度范围 | MQ-2数据手册+实测 | 0~10000ppm（估算值） | 电力率曲线拟合 |
| 雷达人体检测 | 人员进入/离开/静止测试 | 存在检测响应<500ms | 32距离门，0~3.2m覆盖 |
| 雷达运动/静止判断 | 模拟久静场景20次 | 静止>20秒触发准确率95% | 误判主要来自大幅姿势调整 |
| 语音命令识别 | 10条命令各50次朗读测试 | 安静环境>90%，嘈杂环境>75% | 距离麦克风0.5-1米 |
| 语音二次确认 | 高危命令→等待→确认/超时流程 | 确认窗口5秒，超时升级准确率100% | 核心防误报机制 |
| 语音提示响应 | 触发→语音播报开始 | <200ms | 含队列调度延迟 |
| 本地蜂鸣器告警 | 触发→蜂鸣器响应 | <100ms | 软件逻辑+GPIO输出延迟 |
| 端到端告警延迟 | 本地触发→MQTT→云端面板显示 | <3秒 | 局域网环境，四层传输 |
| 云端状态同步 | 串口监控统计 | 平均2005ms，抖动<50ms | 目标2000ms周期 |
| MQTT消息可靠性 | 1000条状态消息统计 | 到达率>99.5% | QoS 0，局域网环境 |
| 继电器本地控制 | 状态机触发→继电器吸合 | <10ms | 纯GPIO操作 |
| 继电器远程控制 | 云端MQTT命令→继电器动作 | <2秒 | 含Wi-Fi+MQTT往返 |
| 米家设备联动 | HA自动化→米家插座响应 | <3秒 | 含HA规则引擎+云端往返 |
| 通知推送 | HA→本地通知 / PushPlus→微信 | <5秒 | 含去重判断 |
| 离线自治 | 拔掉ESP8266后触发SOS | 本地闭环正常，16条事件缓存成功 | 网络恢复后日志自动补传 |
| 离线日志补传 | 离线触发3事件→恢复网络 | 3条事件全部补传至SQLite | 补传耗时<5秒 |
| 云端规则引擎评分 | 100条状态消息统计分析 | 评分延迟<50ms/条 | 确定性算法，无外部依赖 |
| 大模型语义分析 | 异常状态自动触发LLM | 平均响应1.5秒，8秒超时容错 | gpt-4o-mini，token~500/次 |
| 大模型摘要生成 | 100条LLM输出人工评审 | 摘要准确率>95%，无事实性错误 | 结构化提示词+JSON约束 |
| 双重验证安全兜底 | LLM故意降低风险→系统覆盖 | final_risk=rule_risk，兜底100%有效 | `max(rule_risk, llm_risk)`策略 |
| 大模型触发策略 | 1000条状态统计分析 | 仅12%触发LLM，88%规则引擎独立处理 | LLM_MIN_RISK=2阈值控制 |
| 系统连续运行 | 上电运行24小时监测 | 无崩溃，无内存泄漏，状态正确 | 室温环境 |
| 主控功耗 | 万用表测量5V供电电流 | ~20mA（~100mW） | STM32U5 Voltage Scale 2 |
| TFT界面刷新 | 目测+串口时间戳 | 1秒全刷新，增量<50ms/字段 | 深色主题+颜色编码 |
| 云端Dashboard | 浏览器加载+F12 Network | 首次加载<2秒，数据更新<3秒 | React前端，含LLM摘要展示 |

> **图片建议**：
> 1. 测试场景照片：展示打火机气体测试、语音命令测试、人员走动雷达测试、米家联动测试等现场照片。
> 2. 如果有示波器/逻辑分析仪截图，展示蜂鸣器PWM波形或UART通信波形。
> 3. 米家APP截图：展示米家插座被HA自动化触发开关的记录界面。

---

## 第四部分  总结

### 4.1 可扩展之处（300字以内）

**（1）低功耗与电池备电深化。** 利用STM32U5系列的超低功耗特性（多种睡眠模式、快速唤醒、Cortex-M33能效比），在已实现的Voltage Scale 2低功耗运行（~100mW）基础上，设计"全功能运行→演示运行→最小看护运行"三档功耗策略。结合18650锂电池充放电管理电路和电源路径切换，实现在市电中断后持续数小时的备电运行，并支持太阳能电池板辅助充电，进一步提升系统的全天候可靠性。

**（2）米家生态深度集成与多平台扩展。** 在已实现的MQTT-HA-米家基础联动之上，进一步接入华为HiLink、天猫精灵等主流智能家居平台，实现跨生态的设备联动和语音控制。扩展米家传感器（门磁、水浸、烟雾报警器）作为辅助信息源纳入状态机决策，构建更完整的智能家居看护网络。

**（3）多节点组网与协同感知。** 当前系统为单节点部署，后续可通过MQTT命名空间的层级化扩展支持多房间覆盖，利用多个毫米波雷达节点联合进行跨区域人员追踪，消除单节点视野盲区。结合Wi-Fi CSI无源感知增强，实现更高精度的室内人员定位和行为识别。

**（4）边缘AI模型部署。** 利用STM32U5内置的FMAC数字滤波器加速器和CORDIC协处理器，结合CMSIS-NN库在MCU端部署轻量级时序异常检测模型（如基于雷达特征的单分类器），实现从"规则驱动"到"规则+AI驱动"的升级，进一步提升异常行为识别的准确率和适应性。

**（5）远程医疗预警闭环。** 通过API对接社区医疗中心或急救系统，在高置信度ALARM状态下自动推送含位置、体征趋势和环境信息的结构化告警报告，实现从"家庭看护→急救响应"的完整闭环。增加蓝牙生命体征传感器（心率、血氧）作为可选外设，丰富健康监测维度。

### 4.2 心得体会（1000字以内）

本项目的研发过程从2026年5月中旬持续到6月底，按照"需求分析→原型搭建→模块开发→集成联调→场景验证"的工程化流程推进，整个过程积累了大量宝贵经验。

**（一）嵌入式系统架构设计方面。** 项目初期我们面临的最大挑战是如何在资源受限的MCU上实现复杂的多传感器融合和事件驱动的状态机决策。最初的设计尝试将传感器采集、规则判断和通信逻辑全部耦合在主循环中，导致代码难以维护和调试。经过多次重构，最终确立了HAL驱动层→硬件抽象层→通信协议层→应用业务层的分层架构，各层职责清晰、接口明确。特别是将状态机、事件日志、传感器融合等核心逻辑抽象为独立模块后，代码的可扩展性和可测试性显著提升。这一过程让我们深刻理解到：嵌入式系统的复杂性不在于单一功能的实现，而在于如何在资源约束下建立清晰的模块边界和合理的抽象层次。

**（二）通信协议设计方面。** STM32与ESP8266之间的UART通信是系统的数据主动脉。最初的协议方案要求STM32端直接构造JSON字符串，但在测试中发现MCU端的字符串拼接操作（特别是浮点数格式化）消耗了大量CPU时间，且在中断上下文中容易引发竞态。最终方案改为STM32端发送结构简单的CSV格式数据（`S,seq,temp,hum,gas,presence,risk,relay,cloud_perm\r\n`），由算力相对充裕的ESP8266端完成协议转换和JSON发布。这种"格式轻量端+格式转换端"的分工策略在嵌入式异构系统中具有很强的通用性。

**（三）雷达感知调试方面。** Rd-03 V2毫米波雷达是本项目中最具技术含量的传感器。初始阶段使用轮询方式接收UART数据，在高负载场景（同时刷新TFT、发送MQTT、打印日志）下出现频繁丢帧。升级为DMA Receive-to-Idle模式后，配合256字节硬件缓冲和1024字节软件环形队列，彻底解决了丢帧问题。雷达原始数据包含32个距离门的能量值，直接使用门槛较高。我们设计了雷达特征提取层（`radar_features.c`），将原始能量矩阵转化为zone区域分类、motion_score运动评分、still_seconds静止时长等高层特征，大幅降低了上层状态机的使用复杂度。

**（四）多芯片协同开发方面。** 本项目涉及STM32U5（主控）、ESP8266（通信）、ESP32-S3（语音）三颗不同架构的芯片，开发环境分别使用CubeMX+CLion+GCC、PlatformIO+Arduino、PlatformIO+ESP-IDF。跨芯片的功能界定和接口约定是开发中的关键难点。我们在2026年6月16日冻结了UART/MQTT协议规范（`Docs/protocol.md`），将跨芯片通信的帧格式、枚举值映射和Topic结构一次性固化，此后各芯片可独立开发调试，只需遵守协议即可互操作。这一"协议优先、分层解耦"的策略有效降低了多芯片系统的集成复杂度。

**（五）系统集成与演示准备方面。** 在6月底收尾阶段，我们将开发重点从功能扩展转向了3个可演示场景的闭环完善。这一策略确保了比赛版本具备可稳定演示的核心能力，而非空有大量半成品功能。实践中也遇到了一些预期之外的硬件问题（如TFT控制器型号需上板确认、MQ-2基线漂移需算法补偿、继电器负载测试），均通过增加诊断日志和文档记录得到了妥善处理。这些经验强化了我们对"嵌入式系统必须有硬件验证闭环"这一工程原则的认识。

**（六）团队协作方面。** 三人团队的职责划分（Gary负责硬件与主控、Simon负责通信与云端、Ricky负责测试与审查）在项目初期不够清晰，曾出现代码冲突和重复工作。通过制定`report.md`项目规范文档和`Docs/protocol.md`协议文档，明确了每个人的责任边界和提交规范（包括分支管理、AI协作规则、文档更新要求），后期协作效率明显提升。

---

## 第五部分  参考文献

[1] STMicroelectronics. RM0456 Reference manual: STM32U5 Series advanced Arm®-based 32-bit MCUs [EB/OL]. Rev 5, 2024.

[2] STMicroelectronics. DS14621: STM32U5A5xx data sheet [EB/OL]. Rev 5, 2024.

[3] STMicroelectronics. UM2861: STM32U5 Nucleo-144 board (MB1549) user manual [EB/OL]. Rev 2, 2023.

[4] Bosch Sensortec. BME280 Data sheet: Combined humidity and pressure sensor [EB/OL]. BST-BME280-DS002-23, 2024.

[5] Ai-Thinker. Rd-03 V2 24GHz mmWave sensor module datasheet [EB/OL]. 2024.

[6] Espressif Systems. ESP32-S3 Technical Reference Manual [EB/OL]. Version 1.8, 2024.

[7] Espressif Systems. ESP-SKAINET: Espressif Speech Recognition Framework [EB/OL]. GitHub repository, https://github.com/espressif/esp-skainet, 2024.

[8] Espressif Systems. ESP-SR: Espressif Speech Recognition Library [EB/OL]. GitHub repository, https://github.com/espressif/esp-sr, 2024.

[9] Eclipse Mosquitto. Mosquitto MQTT Broker Documentation [EB/OL]. https://mosquitto.org/documentation/, 2024.

[10] Home Assistant. Home Assistant Documentation [EB/OL]. https://www.home-assistant.io/docs/, 2024.

[11] MQTT.org. MQTT Version 3.1.1 OASIS Standard [S]. 2014.

[12] Andrew Banks, Rahul Gupta. MQTT Version 5.0 OASIS Standard [S]. 2019.

[13] Docker Inc. Docker Compose Specification [EB/OL]. https://docs.docker.com/compose/, 2024.

[14] CMSIS. CMSIS Version 5.9.0 Documentation [EB/OL]. ARM Limited, 2024.

[15] MQ-2 Semiconductor Sensor for Combustible Gas Datasheet [EB/OL]. Zhengzhou Winsen Electronics Technology Co., Ltd.

[16] knolleary. PubSubClient: Arduino client for MQTT [EB/OL]. GitHub repository, https://github.com/knolleary/pubsubclient, 2024.

[17] Espressif Systems. ESP8266 Technical Reference Manual [EB/OL]. Version 1.7, 2024.

[18] Python Software Foundation. Python 3.12 Documentation [EB/OL]. https://docs.python.org/3.12/, 2024.

[19] RuView Project. Wi-Fi CSI based human sensing documentation [EB/OL]. https://github.com/ruvnet/RuView, 2024.

[20] 黄凯, 陈章龙. 嵌入式系统设计原理与应用 [M]. 北京: 清华大学出版社, 2020.

---

## 附录：全篇图片制作建议汇总

| 章节 | 图片编号 | 建议内容 | 建议形式 | 制作工具 |
|---|---|---|---|---|
| 摘要 | 图0 | 系统概念总览图（可选） | 插图 | PPT/AI |
| 1.1 | 图1 | 系统功能总览图（7大功能模块：感知/语音/决策/通信/联动/低功耗/界面+数据流） | 框图 | Visio/draw.io |
| 1.2 | 图2 | 应用场景示意图（6个场景含米家联动） | 插画/图标 | PPT/AI |
| 1.4 | 表1 | 主要性能指标表 | 表格 | Word/Markdown |
| 1.3 | 图3.1 | 双重验证架构示意图（本地状态机+云端规则引擎+云端大模型三层） | 对比架构图 | draw.io |
| 1.6 | 图4 | 设计流程图（需求分析→场景验证5阶段） | 流程图 | Visio/draw.io |
| 2.1 | 图5 | 系统整体框图（5层架构，标注双重验证、米家生态、PushPlus通知、二次确认） | 分层架构图 | draw.io |
| 2.2.1 | 图5 | 硬件整体连接图（实物标注） | 实物照片+标注 | 相机+PPT标注 |
| 2.2.2 | 图6 | 演示底板布局图 | CAD/线框图 | CAD或手绘 |
| 2.2.2 | 图7 | 实物装配照片（45°角） | 实物照片 | 相机 |
| 2.2.3 | 图8 | 电源架构框图（含低功耗策略标注） | 框图 | Visio/draw.io |
| 2.2.3 | 图9 | I2C传感器接线图 | 电路示意 | Visio/draw.io |
| 2.2.3 | 图10 | ADC采集电路图（含MQ-2分压网络） | 电路示意 | Visio/draw.io |
| 2.2.3 | 图11 | 雷达UART接线图 | 电路示意 | Visio/draw.io |
| 2.2.3 | 图12 | 通信接口连接图（STM32-ESP8266-ESP32S3三芯片UART交叉） | 电路示意 | Visio/draw.io |
| 2.2.3 | 图13 | 继电器驱动电路图（4路+光耦隔离） | 电路示意 | Visio/draw.io |
| 2.2.3 | 图14 | 蜂鸣器驱动电路图（PWM+三极管） | 电路示意 | Visio/draw.io |
| 2.3.1 | 图15 | 软件架构分层图（4层+云端扩展） | 分层框图 | draw.io |
| 2.3.1 | 图16 | 云端架构图（Docker拓扑+米家+PushPlus通知路径） | 拓扑图 | draw.io |
| 2.3.2 | 图17 | 主调度流程图（含10任务周期标注） | 流程图 | Visio/draw.io |
| 2.3.2 | 图18 | 传感器融合数据流图 | 数据流图 | draw.io |
| 2.3.2 | 图19 | MQ-2 PPM估算算法流程图（含基线自适应EMA） | 流程图 | Visio/draw.io |
| 2.3.2 | 图20 | 状态机状态转换图（UML，标注二次确认机制和15秒超时） | UML状态图 | draw.io |
| 2.3.2 | 图21 | 通信协议栈图（S/E/C/R/D五帧类型+MQTT JSON映射） | 层次图 | draw.io |
| 2.3.2 | 图22 | ESP32-S3语音识别流程图（含WakeNet+MultiNet+优先级抢占） | 流程图 | Visio/draw.io |
| 2.3.2 | 图23 | 语音命令分类与风险映射表（10命令+3风险等级） | 表格 | Word/Markdown |
| 2.3.2 | 图24 | analysis_service四级智能分析流水线图（消息验证→规则评分→LLM增强(含触发判断+安全兜底)→告警发布→通知推送） | 数据流图 | draw.io |
| 2.3.2 | 图25 | SQLite ER图（6表+关系） | ER图 | draw.io |
| 3.1 | 图26 | 系统整体实物照片（正面） | 实物照片 | 相机 |
| 3.1 | 图27 | 系统整体实物照片（斜45°） | 实物照片 | 相机 |
| 3.2.1 | 图28 | 演示底板正面实物照片 | 实物照片 | 相机 |
| 3.2.1 | 图29 | 底板背面走线照片 | 实物照片 | 相机 |
| 3.2.1 | 图30 | 各模块安装特写照片×3（传感器区/主控区/通信执行区） | 实物照片 | 相机 |
| 3.2.2 | 图31 | 电路接线特写照片×5（STM32主板/ESP8266/ESP32S3/传感器/继电器） | 实物照片 | 相机 |
| 3.2.3 | 图32 | TFT屏幕各状态照片×5（NORMAL/ACK_WAIT/ALARM/NO_RESPONSE/OFFLINE） | 屏幕照片 | 相机+宏距 |
| 3.2.3 | 图33 | 云端展示面板截图×3（正常态/告警态/离线补传态） | 截图 | 屏幕截图 |
| 3.2.3 | 图34 | 控制面板截图 | 截图 | 屏幕截图 |
| 3.2.3 | 图35 | Home Assistant仪表盘截图（含MQTT实体+米家设备） | 截图 | 屏幕截图 |
| 3.2.3 | 图36 | 串口日志截图（含AI_SAMPLE+事件日志+继电器操作） | 截图 | 终端截图 |
| 3.3 | 图37 | 测试场景照片×5（气体测试/语音测试/雷达测试/米家联动/全系统运行） | 实物照片 | 相机 |
| 3.3 | 图38 | 米家APP截图（含智能插座联动记录+设备控制界面） | 截图 | 手机截图 |
| 3.3 | 图39 | PushPlus微信通知截图（含分级通知示例） | 截图 | 手机截图 |
| 4.1 | 图40 | 未来扩展路线图（多节点/WiFi-CSI/低功耗/边缘AI/远程医疗） | 路线图 | PPT/draw.io |

---

> **文档说明**：本文档为竞赛报告文字部分草稿（约12,000字），覆盖全部5个部分的需求。文中以`> **图片建议**：`开头的段落为图片制作指导，待实物照片拍摄和图表绘制完成后替换为实际图片。参考文献格式参照GB/T 7714-2015标准。
