MoeMengMoe/stm32-caring-system-project/Modules/README.md

# Modules

自定义模块统一放在此目录下。

每个模块建议提供：

- `Init` 初始化函数
- `Update` 周期更新函数
- `Get` 状态获取函数

模块代码应尽量避免动态内存、长阻塞延时和隐式全局变量依赖。
