MoeMengMoe/stm32-caring-system-project/Docs/hardware_inventory.md

# 项目硬件器件清单

本文档记录已经拿到手的主要器件、实物识别信息和当前开发状态。引脚分配、CubeMX 配置与接线方式仍统一以 `Docs/pinmap.md` 为准。

## 1. 主控板

| 项目 | 信息 |
| --- | --- |
| 产品 | NUCLEO-U5A5ZJ-Q |
| 主控 | STM32U5A5ZJT6Q |
| 板卡修订版 | `MB1549-U5A5ZJQ-C04` |
| 状态 | 已用于当前工程 |

## 2. ESP8266 联网板

| 项目 | 信息 |
| --- | --- |
| 板型 | D1 mini 兼容板 |
| 模组 | ESP-12F / ESP8266MOD |
| USB 接口 | USB-C |
| 实物可见串口与电源丝印 | `5V`、`G`、`RX`、`TX` |
| 状态 | 当前 UART CSV 转 MQTT JSON 网关 |

2026-06-04 新增实物图片：

```text
5c94ac56baace351855f71ed8217d8c7_720.jpg
9b7c903164c0d717cd0887621510ae87_720.jpg
```

## 3. TFT 显示屏

| 项目 | 当前可确认信息 |
| --- | --- |
| 尺寸 | 2.0 英寸 |
| 分辨率 | 240 x 320 |
| PCB 丝印 | `XYTFT-2.0"-SLCM VER1.0` |
| 接口形态 | 8 针只写 4 线 SPI |
| 控制器型号 | 待核对；当前代码默认按 `ST7789` 初始化 |
| 逻辑电压与供电范围 | 当前只允许使用 `3.3V` |
| 状态 | 已分配 STM32 引脚并加入本地状态页代码，待上板验证 |

图片与实物确认的接口丝印为 `BL`、`CS`、`DC`、`RST`、`SDA`、`SCL`、`VCC` 和 `GND`，没有 `SDO`。其中 `SDA/SCL` 是 SPI 数据输入与 SPI 时钟，不是 I2C。仅凭模块外观不能严格确认它使用 ILI9341、ST7789 或其他控制器，也不能确认 `VCC` 是否允许 5V。

在获得商品链接、数据手册或通过上板画面确认控制器型号前：

- 只使用 `3.3V` 供电与 `3.3V` 逻辑。
- 不将控制器型号写成已确认事实。
- 如果背光亮但画面始终为空白，优先检查控制器型号与初始化序列，不盲目更换接线。

2026-06-04 新增实物图片：

```text
fba9467054c81514c6de0eb50360fc74_720.jpg
6852b27eec63c4fd8b5978e541b832f1_720.jpg
55a1c588c52d40eeff403d376d77af03_720.jpg
```

## 4. 其他当前检测器件

| 器件 | 当前用途 | 状态 |
| --- | --- | --- |
| BME280 | 温度、湿度、气压 | 已验证 |
| MQ 模块 | AO 模拟电压采样 | 已验证接入，仍需稳定性与标定实验 |
| HC-SR501 PIR | 人体活动数字检测 | 已验证 |
| Rd-03 V2 | 人体存在、距离、距离门能量 | OT2 与 UART 已验证 |
