MoeMengMoe/stm32-caring-system-project/Docs/bugs.md

# Bugs

用于记录已发现问题、定位过程、临时规避方案和最终修复状态。

| 日期 | 问题 | 影响 | 状态 | 负责人 | 备注 |
| --- | --- | --- | --- | --- | --- |
| 2026-05-15 | 暂无 | 无 | Open | Gary | 初始文档 |
