MoeMengMoe/stm32-caring-system-project/stm32-caring-system-project.ioc

Mcu.UserName=STM32U5A5ZJTxQ
PA0.Signal=UART4_TX
PA1.Signal=UART4_RX
PA10.Signal=USART1_RX
PA2.Signal=USART2_TX
PA3.Signal=USART2_RX
PA5.Signal=SPI1_SCK
PA7.Signal=SPI1_MOSI
PA9.Signal=USART1_TX
PB0.GPIO_Label=PIR_IN
PB0.Signal=GPIO_Input
PB10.Signal=USART3_TX
PB11.Signal=USART3_RX
PB8.Signal=I2C1_SCL
PB9.Signal=I2C1_SDA
PC0.GPIO_Label=RELAY4_IN
PC0.Signal=GPIO_Output
PC1.GPIO_Label=RD03_OUT
PC1.Signal=GPIO_Input
PC3.Signal=ADC1_IN4
PC7.GPIO_Label=LED_STATUS
PC7.Signal=GPIO_Output
PD14.GPIO_Label=TFT_CS
PD14.Signal=GPIO_Output
PD15.GPIO_Label=TFT_BL
PD15.Signal=GPIO_Output
PE11.GPIO_Label=RELAY3_IN
PE11.Signal=GPIO_Output
PE13.GPIO_Label=RELAY1_IN
PE13.Signal=GPIO_Output
PE9.Signal=S_TIM1_CH1
PF12.GPIO_Label=TFT_RST
PF12.Signal=GPIO_Output
PF13.GPIO_Label=TFT_DC
PF13.Signal=GPIO_Output
PF14.GPIO_Label=RELAY2_IN
PF14.Signal=GPIO_Output
PG7.GPIO_Label=ACK_BUTTON
PG7.Signal=GPIO_Input
PG8.GPIO_Label=SOS_BUTTON
PG8.Signal=GPIO_Input
