MoeMengMoe/stm32-caring-system-project/esp32-voice-recognition/esp-skainet/examples/cn_speech_commands_recognition/main/main.c

/*
   This example code is in the Public Domain (or CC0 licensed, at your option.)

   Unless required by applicable law or agreed to in writing, this
   software is distributed on an "AS IS" BASIS, WITHOUT WARRANTIES OR
   CONDITIONS OF ANY KIND, either express or implied.
*/
#include <stdio.h>
#include <stdlib.h>
#include <string.h>
#include "freertos/FreeRTOS.h"
#include "freertos/task.h"
#include "esp_err.h"
#include "esp_mn_speech_commands.h"
#include "esp_wn_iface.h"
#include "esp_wn_models.h"
#include "esp_afe_sr_iface.h"
#include "esp_afe_sr_models.h"
#include "esp_mn_iface.h"
#include "esp_mn_models.h"
#include "esp_board_init.h"
#include "speech_commands_action.h"
#include "model_path.h"
#include "app_care_logic.h"

int wakeup_flag = 0;
static const esp_afe_sr_iface_t *afe_handle = NULL;
static esp_afe_sr_data_t *afe_data = NULL;
static volatile int task_flag = 0;
srmodel_list_t *models = NULL;

static const struct {
    int command_id;
    const char *phrase;
} care_commands[] = {
    {1001, "jiu ming"},
    {1002, "wo shuai dao le"},
    {1003, "xiong kou teng"},
    {1005, "li ji bao jing"},
    {1006, "que ren bao jing"},
    {2001, "wo bu shu fu"},
    {2002, "tou yun"},
    {2003, "wo yao bang zhu"},
    {0, "qu xiao bao jing"},
    {1, "wo mei shi"},
};

static void register_care_speech_commands(const esp_mn_iface_t *multinet, model_iface_data_t *model_data)
{
    ESP_ERROR_CHECK(esp_mn_commands_alloc(multinet, model_data));
    ESP_ERROR_CHECK(esp_mn_commands_clear());

    for (int i = 0; i < sizeof(care_commands) / sizeof(care_commands[0]); i++) {
        ESP_ERROR_CHECK(esp_mn_commands_add(care_commands[i].command_id, care_commands[i].phrase));
    }

    esp_mn_error_t *errors = esp_mn_commands_update();
    if (errors && errors->num > 0) {
        printf("speech command update failed, invalid phrases: %d\n", errors->num);
        for (int i = 0; i < errors->num; i++) {
            printf("invalid command_id:%d phrase:%s\n",
                   errors->phrases[i]->command_id,
                   errors->phrases[i]->string ? errors->phrases[i]->string : "");
        }
        abort();
    }
}

void feed_Task(void *arg)
{
    esp_afe_sr_data_t *afe_data = arg;
    int audio_chunksize = afe_handle->get_feed_chunksize(afe_data);
    int nch = afe_handle->get_feed_channel_num(afe_data);
    int feed_channel = esp_get_feed_channel();
    assert(nch == feed_channel);
    int16_t *i2s_buff = malloc(audio_chunksize * sizeof(int16_t) * feed_channel);
    assert(i2s_buff);

    while (task_flag) {
        esp_get_feed_data(true, i2s_buff, audio_chunksize * sizeof(int16_t) * feed_channel);

        if (care_voice_is_busy() || care_voice_is_in_cooldown()) {
            memset(i2s_buff, 0, audio_chunksize * sizeof(int16_t) * feed_channel);
        }

        afe_handle->feed(afe_data, i2s_buff);
    }
    if (i2s_buff) {
        free(i2s_buff);
        i2s_buff = NULL;
    }
    vTaskDelete(NULL);
}

void detect_Task(void *arg)
{
    esp_afe_sr_data_t *afe_data = arg;
    int afe_chunksize = afe_handle->get_fetch_chunksize(afe_data);
    char *mn_name = esp_srmodel_filter(models, ESP_MN_PREFIX, ESP_MN_CHINESE);
    printf("multinet:%s\n", mn_name);
    esp_mn_iface_t *multinet = esp_mn_handle_from_name(mn_name);
    model_iface_data_t *model_data = multinet->create(mn_name, 6000);
    register_care_speech_commands(multinet, model_data);
    int mu_chunksize = multinet->get_samp_chunksize(model_data);
    assert(mu_chunksize == afe_chunksize);

    //print active speech commands
    multinet->print_active_speech_commands(model_data);
    printf("------------detect start------------\n");
    while (task_flag) {
        afe_fetch_result_t* res = afe_handle->fetch(afe_data); 
        if (!res || res->ret_value == ESP_FAIL) {
            printf("fetch error!\n");
            break;
        }
        app_care_poll();

        if (care_voice_is_busy() || care_voice_is_in_cooldown()) {
            if (wakeup_flag == 1) {
                multinet->clean(model_data);
            }
            continue;
        }

        if (res->wakeup_state == WAKENET_DETECTED) {
            printf("WAKEWORD DETECTED\n");
            app_care_on_wake();
	        multinet->clean(model_data);
        }

        if (res->raw_data_channels == 1 && res->wakeup_state == WAKENET_DETECTED) {
            wakeup_flag = 1;
        } else if (res->raw_data_channels > 1 && res->wakeup_state == WAKENET_CHANNEL_VERIFIED) {
            // For a multi-channel AFE, it is necessary to wait for the channel to be verified.
            printf("AFE_FETCH_CHANNEL_VERIFIED, channel index: %d\n", res->trigger_channel_id);
            wakeup_flag = 1;
        }

        if (wakeup_flag == 1) {
            esp_mn_state_t mn_state = multinet->detect(model_data, res->data);
            app_care_poll();

            if (mn_state == ESP_MN_STATE_DETECTING) {
                continue;
            }

            if (mn_state == ESP_MN_STATE_DETECTED) {
                esp_mn_results_t *mn_result = multinet->get_results(model_data);
                for (int i = 0; i < mn_result->num; i++) {
                    printf("TOP %d, command_id: %d, phrase_id: %d, string:%s prob: %f\n", 
                    i+1, mn_result->command_id[i], mn_result->phrase_id[i], mn_result->string, mn_result->prob[i]);
                }
                if (mn_result->num > 0) {
                    app_care_on_command(mn_result->command_id[0], mn_result->string, mn_result->prob[0]);
                }
                printf("\n-----------listening-----------\n");
            }

            if (mn_state == ESP_MN_STATE_TIMEOUT) {
                esp_mn_results_t *mn_result = multinet->get_results(model_data);
                printf("timeout, string:%s\n", mn_result->string);
                afe_handle->enable_wakenet(afe_data);
                wakeup_flag = 0;
                printf("\n-----------awaits to be waken up-----------\n");
                continue;
            }
        }
    }
    if (model_data) {
        multinet->destroy(model_data);
        model_data = NULL;
    }
    printf("detect exit\n");
    vTaskDelete(NULL);
}

void app_main()
{
    app_care_init();

    models = esp_srmodel_init("model");
    ESP_ERROR_CHECK(esp_board_init(16000, 1, 16));

    afe_config_t *afe_config = afe_config_init(esp_get_input_format(), models, AFE_TYPE_SR, AFE_MODE_LOW_COST);
    afe_handle = esp_afe_handle_from_config(afe_config);
    esp_afe_sr_data_t *afe_data = afe_handle->create_from_config(afe_config);
    afe_config_free(afe_config);

    task_flag = 1;
    xTaskCreatePinnedToCore(&detect_Task, "detect", 8 * 1024, (void*)afe_data, 5, NULL, 1);
    xTaskCreatePinnedToCore(&feed_Task, "feed", 8 * 1024, (void*)afe_data, 5, NULL, 0);
}
