MoeMengMoe/stm32-caring-system-project/(commit log)

2026-05-23 fix：适配d1 mini芯片
2026-05-28 feat：完成主控对接模块
    - 完成wifi模块对接到主控的所有函数
    - 尚未完善主控
2026-05-28 feat: integrate Gary MCU baseline with WiFi uplink
    - add ADC/I2C/USART generated sources and sensor MVP modules
    - keep ESP8266 MQTT gateway and comm_wifi uplink interface
    - wire CMake sources/includes for comm and sensor modules
2026-05-28 feat: configure USART2 TX DMA
2026-05-31 feat: connect STM32 status DMA UART reporting
    AI-assisted
2026-06-01 feat: 完善了浮点数支持 并补充了引脚对照表 - 此版本主控数据已经全部打通 可以上传
2026-06-05 feat: 完成 Rd-03 V2 雷达接入并新增本地 TFT 状态显示
    - 新增 Rd-03 V2 UART 驱动，支持命令模式 ACK、二进制上报解析、目标距离和 32 距离门能量读取
    - 扩展 SensorMvp 与主循环，将雷达存在状态接入整体传感器状态，并补充周期性雷达调试日志
    - 新增 SPI1、TFT LCD 底层驱动和状态显示模块，本地展示温湿度、气体、人体存在、雷达距离与风险等级
    - 调整 WiFi 通信临界区中断保护，减少显示刷新与串口发送并发冲突
    - 更新 ESP8266 MQTT 网关配置，将 MQTT_HOST 调整为 192.168.10.100
    - 更新 README、引脚说明、验收文档、调试报告和硬件清单，补充 Rd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
2026-06-05 feat: add radar features and stabilize TFT display
    [radar_features.c, radar_features.h, sensor_mvp.c, sensor_mvp.h, status_display.c, stm32-caring-system-project.ioc, tft_lcd.c]
2026-06-07 fix: receive rd03 uart data with dma
    [main.c, rd03_v2.c, rd03_v2.h, sensor_mvp.c, stm32-caring-system-project.ioc]
2026-06-08 feat：添加了对继电器的支持 完善了通信层 并兼容当前接口
    - 需要主控手动更新接口 发送和接收数据
2026-06-08 feat：更新服务器和假数据脚本
2026-06-10 fix：修复服务器端endpoint地址无法访问的问题
2026-06-16 Docs：修改了后续开发方向 注重完成demo 文档以及完成修订
2026-06-17 feat: show all four relays on dashboard AI-assisted
2026-07-05 Add app state machine and fix relay MQTT payloads
    [app_log.c, app_log.h, app_state_machine.c, app_state_machine.h, app_types.c, app_types.h, comm_wifi.c, comm_wifi.h]
2026-07-05 feat: add HA alarm/event sensors and automation rules
2026-07-05 feat: HA host network mode + MQTT fix + docs
    [main.cpp]
2026-07-06 Feat. 完善了服务端网络配置及联调准备
2026-07-06 feat: add local io and relay automation
2026-07-06 feat: add UART4 local voice command input
2026-07-06 Integrate AI sampling and demo fixture planning
    [app_state_machine.c, app_types.c, app_types.h, board_io.c, comm_local.c, comm_wifi.c, comm_wifi.h]
2026-07-06 Add ESP32 voice recognition alarm project
    [partitions.csv, partitions_esp32.csv]
2026-07-06 Harden ESP32 voice alarm UART mapping
2026-07-06 fix(homeassistant): 修复气体排气扇自动化 - 阈值改为150PPM并加入防抖
    - 开启阈值从 9 PPM 改为 > 150 PPM
    - 关闭阈值从 10 PPM 改为 < 150 PPM
    - 加入 for: 防抖机制（ON 持续5秒, OFF 持续10秒）
    - 避免传感器毛刺导致的频繁开关（乒乓效应）
2026-07-07 feat. 完善ESP 32语音识别部分
2026-07-07 修改了一些文档
2026-07-07 Integrate scene engine and delivery docs
    [single_board_v05_layout.scad]
